Averyy/r3d-propane-monitor/docs/README.md

# Docs

| Page | For | Covers |
|---|---|---|
| [build-guide.md](build-guide.md) | Builders | Order, print, cable, wiring, flashing, fitting, checking, sealing |
| [calibration.md](calibration.md) | Builders | Dial types, the angle tables, angle-to-percent conversion |
| [troubleshooting.md](troubleshooting.md) | Builders | Sensor not found, magnet status, wrong readings, cable problems |
| [firmware-notes.md](firmware-notes.md) | Firmware writers | AS5600 interface and timing, sensor power, ESPHome behaviour, how the configuration works |

Board details are in [sensor-board/](../sensor-board/README.md), the printed tip in [gauge-tip/](../gauge-tip/README.md), the generic module option in [module-cap/](../module-cap/README.md), and installing the ESPHome configuration in [esphome/](../esphome/README.md).
