Averyy/r3d-propane-monitor/sensor-board/images/board-3d-angle.png

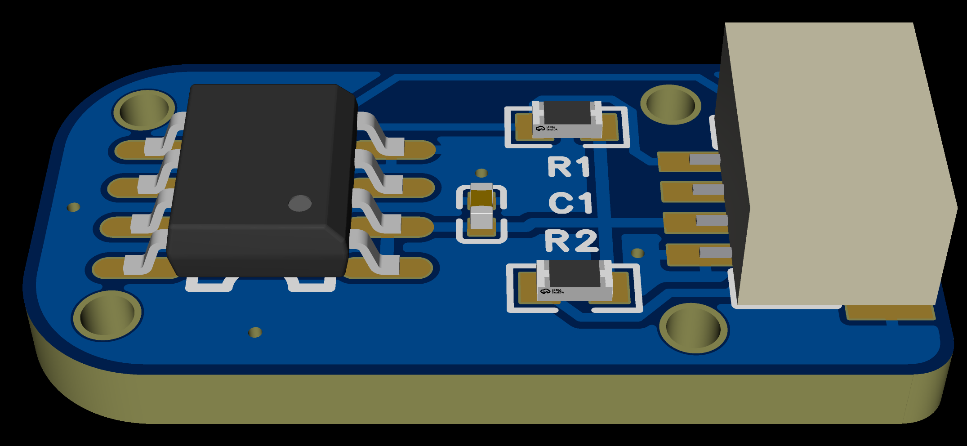
sensor-board/images/board-3d-angle.png
