Averyy/r3d-propane-monitor/sensor-board/images/board-pinout.png

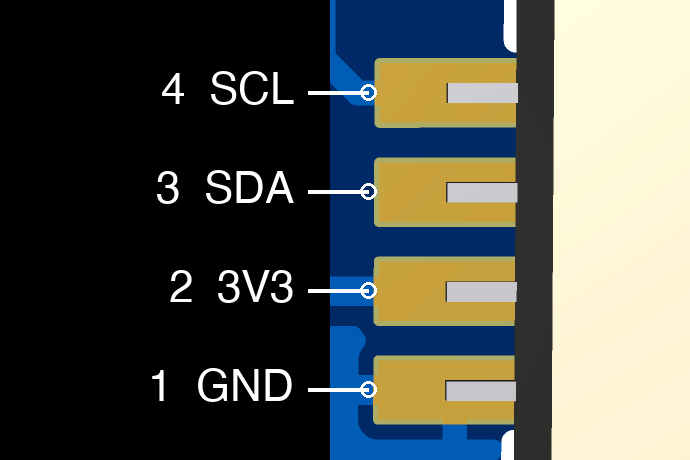
sensor-board/images/board-pinout.png
