Averyy/r3d-propane-monitor/sensor-board/fabrication/propane-gauge-sensor-v4-bom.csv

No. | Quantity | Comment | Designator | Footprint | Value | Manufacturer Part | Manufacturer | Supplier Part | Supplier
1 | 1 | 100nF | C1 | C0402 | 100nF | CL05B104KO5NNNC | SAMSUNG(三星) | C1525 | LCSC
2 | 1 | A1002WR-S-4P | CN1 | CONN-SMD_A1002WR-S-4P |  | A1002WR-S-4P | CJT(长江连接器) | C239522 | LCSC
3 | 2 | 4.7kΩ | R1,R2 | R0603 | 4.7kΩ | 0603WAF4701T5E | UNI-ROYAL(厚声) | C23162 | LCSC
4 | 1 | AS5600-ASOT | U1 | SOIC-8_L5.0-W4.0-P1.27-LS6.0-BL |  | AS5600-ASOT | ams(艾迈斯半导体) | C499458 | LCSC
