Averyy/r3d-propane-monitor/gauge-tip/propane-gauge-tip-2pc-tip.stl

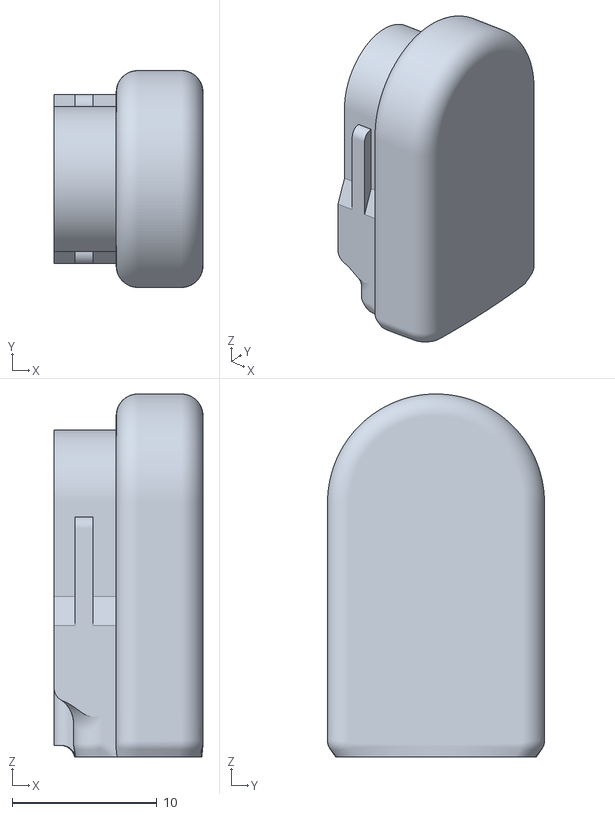
[picture p24: CAD file, 2026-11-10]
gauge-tip/propane-gauge-tip-2pc-tip.stl
10.3 x 15.0 x 25.1
