Averyy/r3d-propane-monitor/module-cap/as5600-module-cap.stl

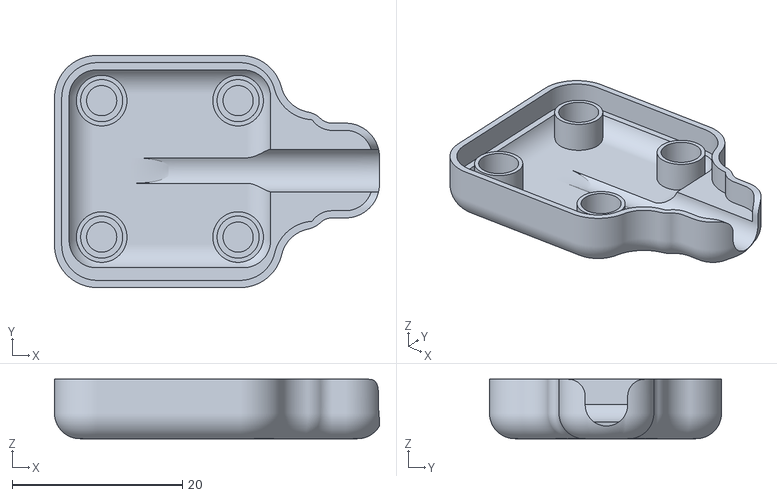
[picture p25: CAD file, 2026-11-10]
module-cap/as5600-module-cap.stl
38.2 x 27.3 x 7.00
