Averyy/r3d-propane-monitor/sensor-board/3d/CN1-CJT-A1002WR-S-4P.step

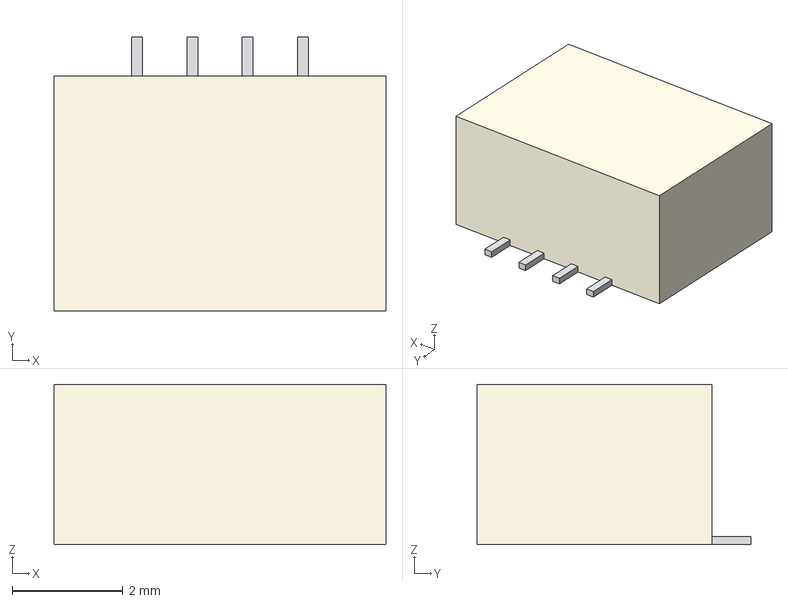
[picture p26: CAD file, 2026-11-10]
sensor-board/3d/CN1-CJT-A1002WR-S-4P.step
6.00 x 4.95 x 2.90 mm
housing
tail_1
tail_2
tail_3
tail_4
