Averyy/r3d-propane-monitor/gauge-tip/propane-gauge-tip-2pc-cable-piece.stl

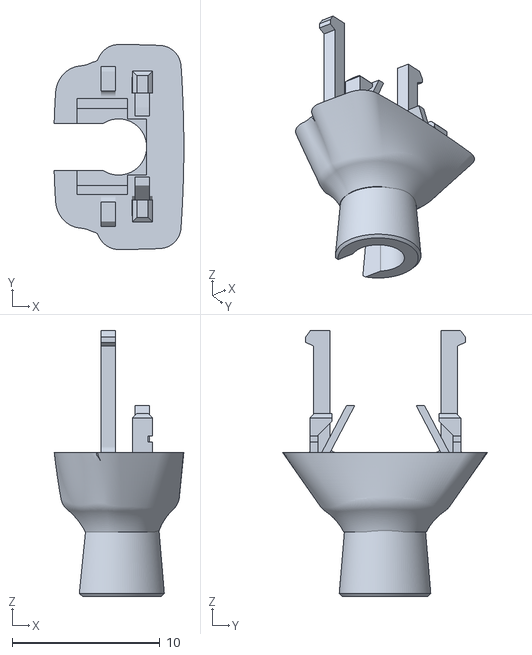
[picture p27: CAD file, 2026-11-10]
gauge-tip/propane-gauge-tip-2pc-cable-piece.stl
8.78 x 13.9 x 18.0
