Averyy/r3d-propane-monitor/module-cap/as5600-module-gauge-reader.stl

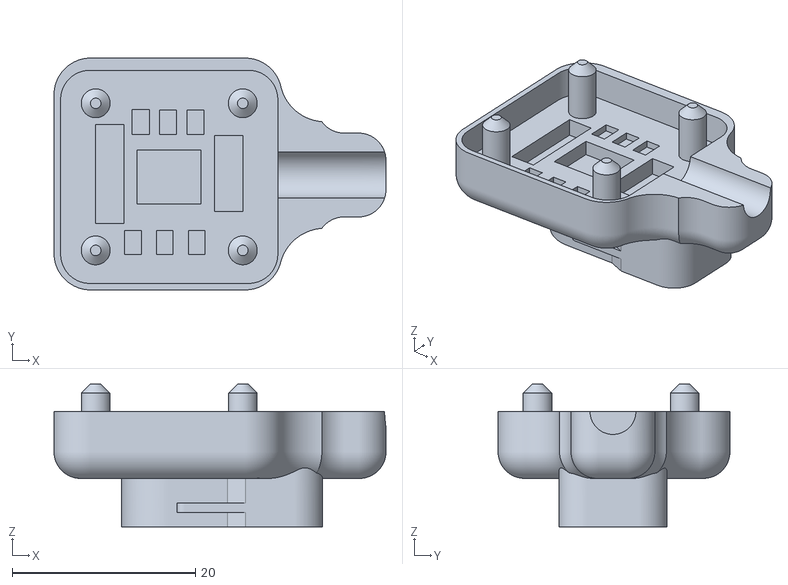
[picture p28: CAD file, 2026-11-10]
module-cap/as5600-module-gauge-reader.stl
36.2 x 25.3 x 15.6
