Averyy/r3d-propane-monitor/sensor-board/3d/propane-gauge-sensor-v4.step

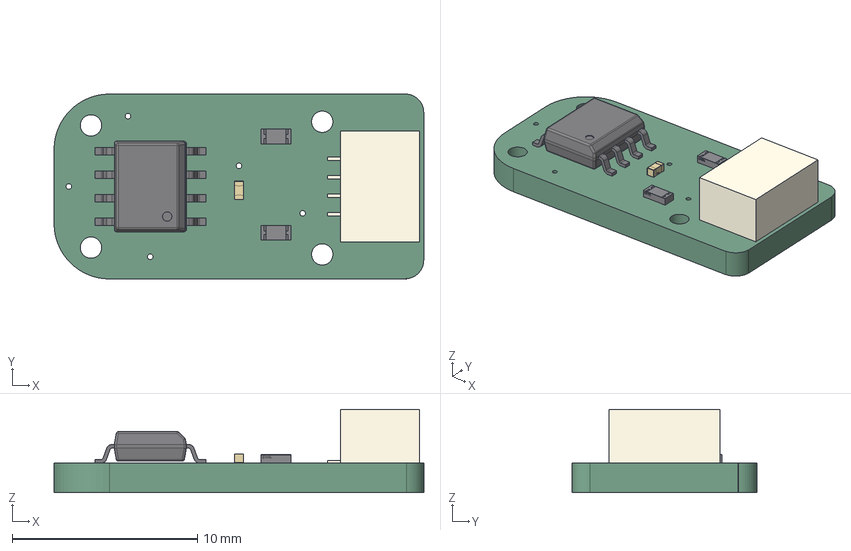
[picture p29: CAD file, 2026-11-10]
sensor-board/3d/propane-gauge-sensor-v4.step
20.0 x 10.0 x 4.50 mm
PCB_20x10x1p6
U1
R1
R2
C1
CN1
