Averyy/r3d-propane-monitor/gauge-tip/propane-gauge-tip-1pc.stl

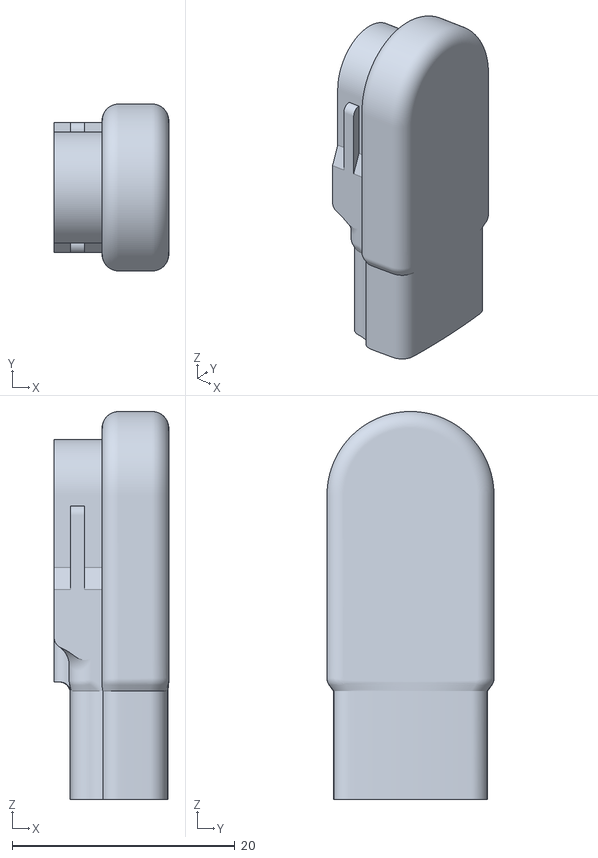
[picture p30: CAD file, 2026-11-10]
gauge-tip/propane-gauge-tip-1pc.stl
10.3 x 15.0 x 34.8
