Averyy/r3d-propane-monitor/sensor-board/schematic.pdf

Cable | Angle sensor

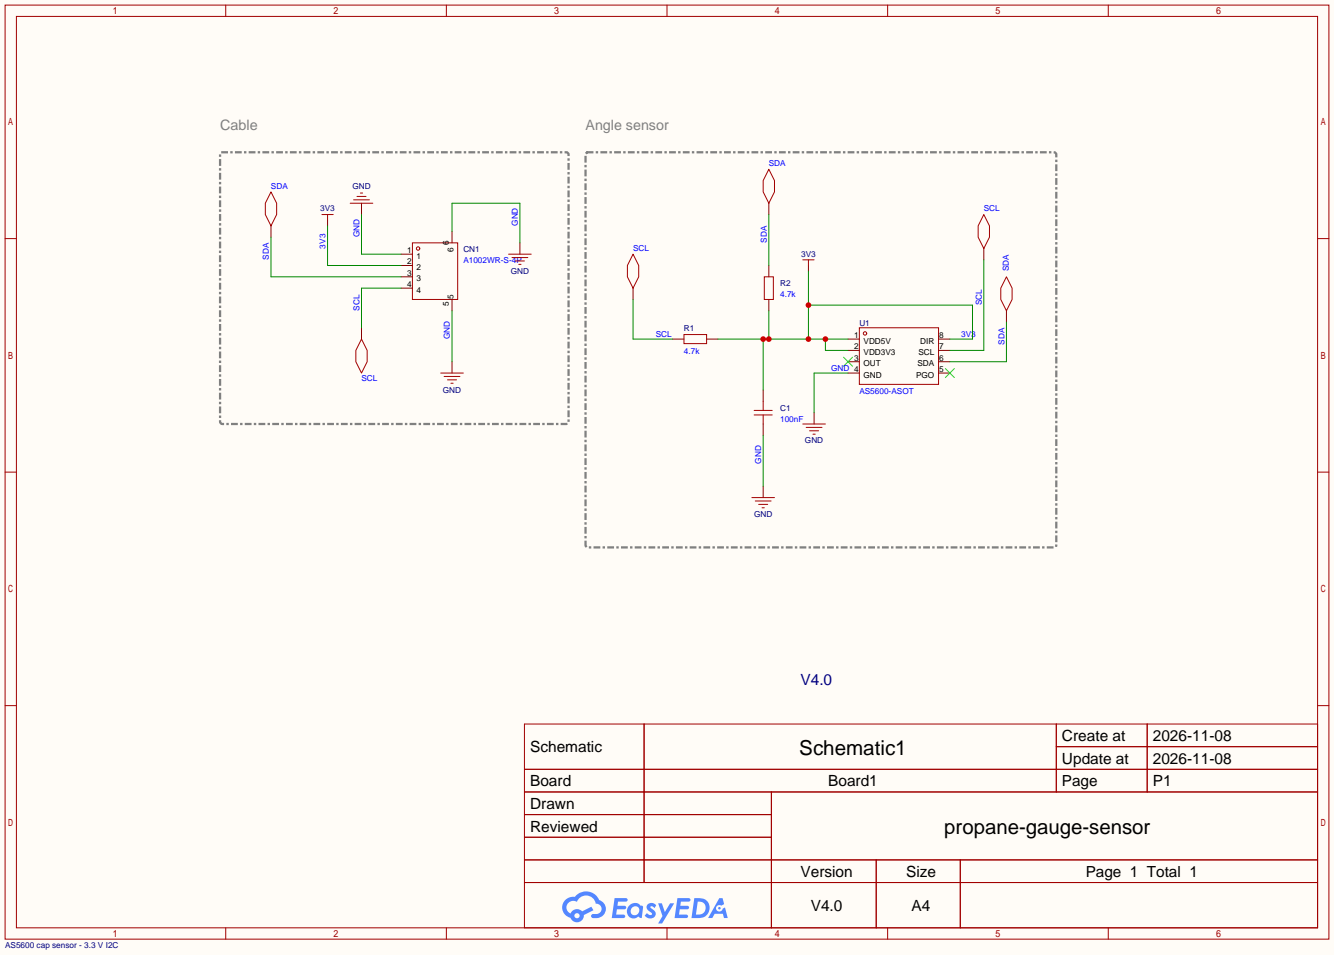
[picture p31: page 1]

Schematic | Schematic1 | Create at | 2026-11-08

Update at | 2026-11-08

Board | Board1 | Page | P1
Drawn | | propane-gauge-sensor
Reviewed

Version | Size | Page 1 Total 1
V4.0 | A4
