Averyy/r3d-propane-monitor/(commit log)

2026-11-10 Sensor board v4, gauge tip, ESPHome configuration and docs
    - Sensor board v4: JLCPCB fabrication files, schematic, 3D model, images
    - Gauge tip: two-piece and one-piece STLs, printing and assembly notes
    - ESPHome: always-on package, battery package (8 h deep sleep, sensor
    powered from a GPIO and switched off while asleep), example config,
    dial-table test and CI build
    - Docs: build guide, dial types and calibration, troubleshooting,
    firmware notes
    Claude-Session: https://claude.ai/code/session_011EgBK3xdf3BqmJET1gfmhQ
    [CN1-CJT-A1002WR-S-4P.step, propane-gauge-sensor-v4-bom.csv, propane-gauge-sensor-v4.step, propane-gauge-tip-1pc.stl, propane-gauge-tip-2pc-cable-piece.stl, propane-gauge-tip-2pc-tip.stl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]
2026-11-10 Add generic AS5600 module housing and README edits
    - module-cap/: gauge reader and cap STLs, renders and README for a generic AS5600 breakout
    - README: module option section, status line, banner and intro rewording
    - Build guide, troubleshooting, contributing, changelog and issue template mention the module housing
    [as5600-module-cap.stl, as5600-module-gauge-reader.stl]
2026-11-10 Release as v1.0, encrypt OTA in example.yaml
    - Package tag v4.0 -> v1.0 in example.yaml and esphome/README; v4 stays the board revision
    - Changelog: release v1.0 maps to board v4, tips v2/v1, module housing and first ESPHome config
    - CI: example.yaml check matches any release tag
    - example.yaml: OTA uses the api encryption key instead of a password; drop ota_password from secrets.yaml.example
2026-11-11 Bench-tested ESPHome configuration: magnitude magnet check, live entities, Custom table
    - Magnet missing now means Magnitude below 50 (STATUS reads 2 on a gauge's weak field even when reading fine); reads without the magnet never reach the angle median
    - Sensor problem is internal: Tank level shows unknown instead; one delayed_on_off filter (3 s on, 5 s off)
    - Angle live and Tank level live: every reading, unknown while the magnet is missing
    - Dial type starts as Jr/Sr Horizontal; Default removed; Custom table from the propane_custom_table substitution
    - Angle offset -180 to +180 degrees, wrapped into 0-360, so a turned sensor can be corrected
    - Battery mode uses Wi-Fi fast connect
    - Host te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
    [propane-monitor.yaml]
2026-11-11 README rewrite for publishing, release v1.0
    - README: tighter intro and status table, one-paragraph build overview, entity table, board and gauge tip render restored
    - CHANGELOG: v1.0 dated 2026-11-10
2026-11-11 README layout: render at the top, photos side by side, module option before wiring
    - Board and gauge tip render is the top image
    - Photo of the tip on the dial and the cable-end photo side by side in Build; cable-end photo recropped to the same 3:2 shape
    - Generic module option moved up after What you need, ahead of Build and Wiring
2026-11-11 README: drop the Status section and the pinout image
    - Status table replaced by one sentence after the intro: v4 not built yet, earlier revision worked, per-part testing in the changelog
    - Pinout image removed from Wiring; the pin table covers it and the sensor board page links the image
2026-11-11 v1.0.1: keep the angle median correct at the 0/360 point, restart step in the build guide
    - Angle filter keeps consecutive reads continuous across 0/360 before the median and wraps after it; a turned sensor could otherwise average to about 180 degrees
    - Host test runs the angle filters around a copy of ESPHome's median (seam, mid-dial, dropped reads)
    - Build guide and README: restart the device after plugging the sensor in
    - example.yaml and esphome/README pin @v1.0.1; changelog entry
    [propane-monitor.yaml]
2026-11-11 Point questions and board or housing ideas to Discussions
    - Issue chooser: Question and Idea links to the Q&A and Ideas categories
    - CONTRIBUTING: Ask a question section; board or housing changes go to Ideas, since blank issues are off
2026-11-11 Ordering: fix greyed-out Economic PCBA, add cable length guide
    - Ordering: set Surface Finish to HASL (an OSP default blocks Economic); the Tooling holes option only appears once Economic is selected; desktop app for lower prices and coupons; Global Standard Direct Line shipping; cable not included
    - Cost: desktop-app vs website board price, shipping estimate
    - Build guide: how long the cable can be, with options for longer runs
    - Troubleshooting: keep combined pull-ups at 1 kΩ or more, link to the cable length section
